FYSETC/FYSETC-AIO_II/(threads)

Thread 3 (2020-04-10):

Schemes and other bits for module 4xTMC2208 for AIO II board

sl1pkn07, 2020-04-10:
Hi

i just discover exist a module for this board with TMC2208 drivers

https://es.aliexpress.com/item/4000337065284.htm

is possible add to the repo the schemes/layout/otherbits to the repo?

greetings

Cadaxe20000, 2020-05-11:
I have ordered one with 2208 and I can't find anywhere how to resolve compailing issues for 2208 pins

sl1pkn07, 2020-06-26:
unit received today

any notice of the schemes and push the marlin configuratin for this drivers in upstream?

greetings

Cadaxe20000, 2020-06-26:
No, I did asks manufacturer few times and usually they reply everything is
included on GitHub.

On Fri, 26 Jun 2020, 14:47 Gustavo Alvarez, <notifications@github.com>
wrote:

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

sl1pkn07, 2022-02-23:
practically almost 2 years later, but now done

tnx!

Closed 2022-02-23.

Thread 5 (2020-05-17):

Use AIO II with other projects than 3dprinter (SMuFF Feder). problem with the display and u8g2 lib

sl1pkn07, 2020-05-17:
Hi. i whant add support for this board in this project

https://github.com/technik-gegg/SMuFF-1.1

the pinout is set, but the display show nothing. the library used for the display is the u8g2 https://github.com/olikraus/u8g2 and set as `U8G2_ST7567_JLX12864_1_4W_HW_SPI` and also test with `U8G2_UC1701_MINI12864_1_4W_HW_SPI`

i also test the demo posted in https://github.com/olikraus/u8g2/wiki/u8g2setupcpp#introduction, but not sucess

what display controller use the AIO II?

the display seems (the code engraved in the display flat wire is LX-12864B11-3)

greetings

sl1pkn07, 2020-06-26:
fixed. need disable the JTAG pinouts in order to use the LCD

the u8g2 constructor for the LCD is `U8G2_UC1701_MINI12864_1_4W_HW_SPI`

greetings

Closed 2020-06-26.

Thread 6 (2020-05-23):

AIO II Fan1 no output

OutcastZeroOne, 2020-05-23:
Have confirmed with 2 different AIO II. one with original factory firmware, second with custom. Neither one will power the controllable fan output. I have full voltage out, but no ground signal.

OutcastZeroOne, 2020-05-25:
So far I have tried 2 different fans. confirmed full power out on the positive side of the Fan1 plug, but no ground side signal. Since half of the MOSFET that is used for the fan1 is also used for teh Blue side of the RGB control, I know that the MOSFET is functional, at least on half of the chip.

It was mentioned that there is a known issue in Marlin about a conflict with the Buzzer and PWM control. I have dissabled the Buzzer pin in the pin config and still no change.

OutcastZeroOne, 2020-06-01:
After 2 weeks of trying to get this AIO II fan1 to work, I have come to the conclusion that the board is defective. I have confirmed full power at the plug, but I have never been able to get a ground signal. I have been working directly with the Marlin developers, several of whom have AIO II boards and have tried my configuration of firmware on their boards and are able to have the fan1 fully operational.

Thread 7 (2020-11-29):

Unable to use P4 serial port pinheader

sl1pkn07, 2020-11-29:
related

https://github.com/FYSETC/Marlin-2.0.x-FYSETC/issues/21

greetings

TuguanLing, 2020-11-30:
Hello, I tested according to your configuration, it can be received and sent normally, you should be connected to the wrong line, USART2_TX and USART2_RX are PA2 and PA3 respectively. In addition, USART2 has been used in TMC2208's uart mode. Although it can receive and send instructions, it also receives instructions from TMC2208's uart mode. It is recommended not to use USART2.

sl1pkn07, 2020-11-30:
Hi

then, i can't use P4 port if use the 4xTMC2208 module? then what happen if use the the P6 header (pin header near the USB port)? is usart1 (througth CH340 bridge). the usb is irrelevant for me (only when i need flash the formware)

greetings

TuguanLing, 2020-12-01:
If you use USART1, you do not need to turn on SERIAL_PORT_2,USB to send instructions and burn firmware, but the P6 interface cannot be directly used for WiFi modules to send instructions. USART1_TX and USART1_RX need to be extracted from MCU. Check the schematic diagram in detail

sl1pkn07, 2020-12-01:
according to STM32f103RCT6 datasheet (https://www.st.com/resource/en/datasheet/stm32f103rc.pdf) this Mcu, also have USART3, wich in AIOII schemes, is also the P4 header, the low row (PB10 (SCL) and PB11 (SCA))

but this connection, have 2 resistors (4,7K). exist any problem if i use as serial port as-sis? or i need retire the resistors?

greetings

TuguanLing, 2020-12-02:
USART3 can be used normally, no need to retire the resistors, does not affect the normal use.

sl1pkn07, 2020-12-02:
thanks for confirm . i have tested in my 2 units units and works ok in USART3 (`SERIAL_PORT_2 3`) (when use 4xTMC2208 module) and  USART2 (`SERIAL_PORT_2 2`) and USART3 (`SERIAL_PORT_2 3`) when use 4xST820 module

greetings

PD: is cross-related with https://github.com/FYSETC/FYSETC-AIO_II/issues/3. 4xTMC2208 module schemes and other bits is missing in the repository

Closed 2020-12-02.

Thread 8 (2021-08-21):

How to connect 3D Touch/ BL Touch to AIO II

yeohandy, 2021-08-21:
I've just recently acquired the AIO II and would like to use it with 3D Touch/ BL Touch. Do you have instructions for it?

yzheka, 2023-03-22:
If you don't use rgb led, you can use one of R, G or B pins as a control pin for bltouch

Thread 9 (2021-09-10):

please clarify the non documented motor wiring

PGTBoos, 2021-09-10:
PLease can you clarify how to motors are wired ?.
There is a PDF schematics here, but looking from the top of it, I cannot tell how it is wired.
It seems connecters X Y are 180 degree turned, as compared to up and down

As for up and down is their wiring   Red Bleu Green Black   ?
I'm replacing a Sanguinololu microcontroller, they have it pretty clear : https://reprap.org/wiki/File:Sanguinololu12.svg

Thread 10 (2024-02-15):

Add AIO II Klipper config

Xerusen, 2024-02-15:
I adapted and tested cheetah v1.2 config to work with AIO II
```
# This file contains common pin mappings for the FYSETC AIO II board.
# To use this config, the firmware should be compiled for the
# STM32F103 with "No bootloader" and serial (on USART1 PA10/PA9)
# communication.

# The "make flash" command does not work on the  AIO II. Instead,
# after running "make", run the following command to flash the board:
#  stm32flash -w out/klipper.bin -v -i rts,-dtr,dtr /dev/ttyUSB0

# See docs/Config_Reference.md for a description of parameters.\

[mcu]
serial:/dev/serial/by-id/usb-1a86_USB_Serial-if00-port0
restart_method: cheetah

[printer]
kinematics: cartesian
max_velocity: 300
max_accel: 3000
max_z_velocity: 5
max_z_accel: 100

[stepper_x]
step_pin:PB8
dir_pin: !PB9
enable_pin: !PA8
microsteps: 16
rotation_distance: 40
endstop_pin: ^PA1
position_endstop: 0
position_max: 200
homing_speed: 50

[tmc2208 stepper_x]
uart_pin:PA3
uart_address:0
run_current: 0.8
stealthchop_threshold: 999999

[stepper_y]
step_pin: PB2
dir_pin: !PB3
enable_pin: !PB1
microsteps: 16
rotation_distance: 40
endstop_pin:PA0
position_endstop: 0
position_max: 200
homing_speed: 50

[tmc2209 stepper_y]
uart_pin:PA3
uart_address:1
run_current: 0.800
stealthchop_threshold: 999999

[stepper_z]
step_pin: PC0
dir_pin: PC1
enable_pin: !PC2
microsteps: 16
rotation_distance: 8
endstop_pin: ^PB14
position_endstop: 0
position_max: 200

[tmc2209 stepper_z]
uart_pin:PA3
uart_address:2
run_current: 0.800
stealthchop_threshold: 999999

[extruder]
step_pin: PC15
dir_pin: !PC14
enable_pin: !PC13
microsteps: 16
rotation_distance: 33.500
nozzle_diameter: 0.400
filament_diameter: 1.750
heater_pin: PC6
sensor_type: EPCOS 100K B57560G104F
sensor_pin: PC4
control: pid
pid_kp: 21.527
pid_ki: 1.063
pid_kd: 108.982
min_temp: 0
max_temp: 250

[tmc2209 extruder]
uart_pin:PA3
uart_address:3
run_current: 1.0
stealthchop_threshold: 999999

[heater_bed]
heater_pin: PC7
sensor_type: EPCOS 100K B57560G104F
sensor_pin: PC5
control: pid
pid_kp: 54.027
pid_ki: 0.770
pid_kd: 948.182
min_temp: 0
max_temp: 120

[fan]
pin: PC8

[display]
#	mini12864 LCD Display
lcd_type: uc1701
cs_pin: PB5
a0_pin: PA15
rst_pin: PB4
#   The pins connected to a uc1701 type lcd.
encoder_pins: ^PC10,^PC11
#   The pins connected to encoder. 2 pins must be provided.
click_pin: ^!PC12
#   The pin connected to 'enter' button or encoder 'click'.
contrast: 63
spi_software_miso_pin: PA6
spi_software_mosi_pin: PA7
spi_software_sclk_pin: PA5

[led fysetc_mini12864]
red_pin:PB0
green_pin:PB6
blue_pin:PB7
#   The pin controlling the given LED color.
cycle_time: 0.010
#   The amount of time (in seconds) per PWM cycle.
#hardware_pwm: False
#   Enable this to use hardware PWM instead of software PWM.
initial_RED: 0.0
initial_GREEN: 1.0
initial_BLUE: 0.0
#   Sets the initial LED color. Each value should be between 0.0 and
#   1.0. The default for each color is 0.

[output_pin BEEPER_Pin]
pin: PC9
pwm: true
value: 0
shutdown_value: 0
cycle_time: 0.001
scale: 1000
```

mrmohaa, 2025-03-18:
A heads up, it looks like the UART addresses for Y and Z are swapped.
Y should be address 2 and Z should be address 1.

Getting my printer running with this board and trying to use sensorless homing and could not get the Y axis to trigger stall guard, X was working fine. Tried swapping UART addresses around and then Y homed fine.
Looked at the 2209 module schematic and the MS1 and MS2 lines set the address, and looking at the 2209 data sheet it confirmed it.
