FYSETC/FYSETC-AIO_II/hardware/4X ST820 V1.2 SCH.pdf

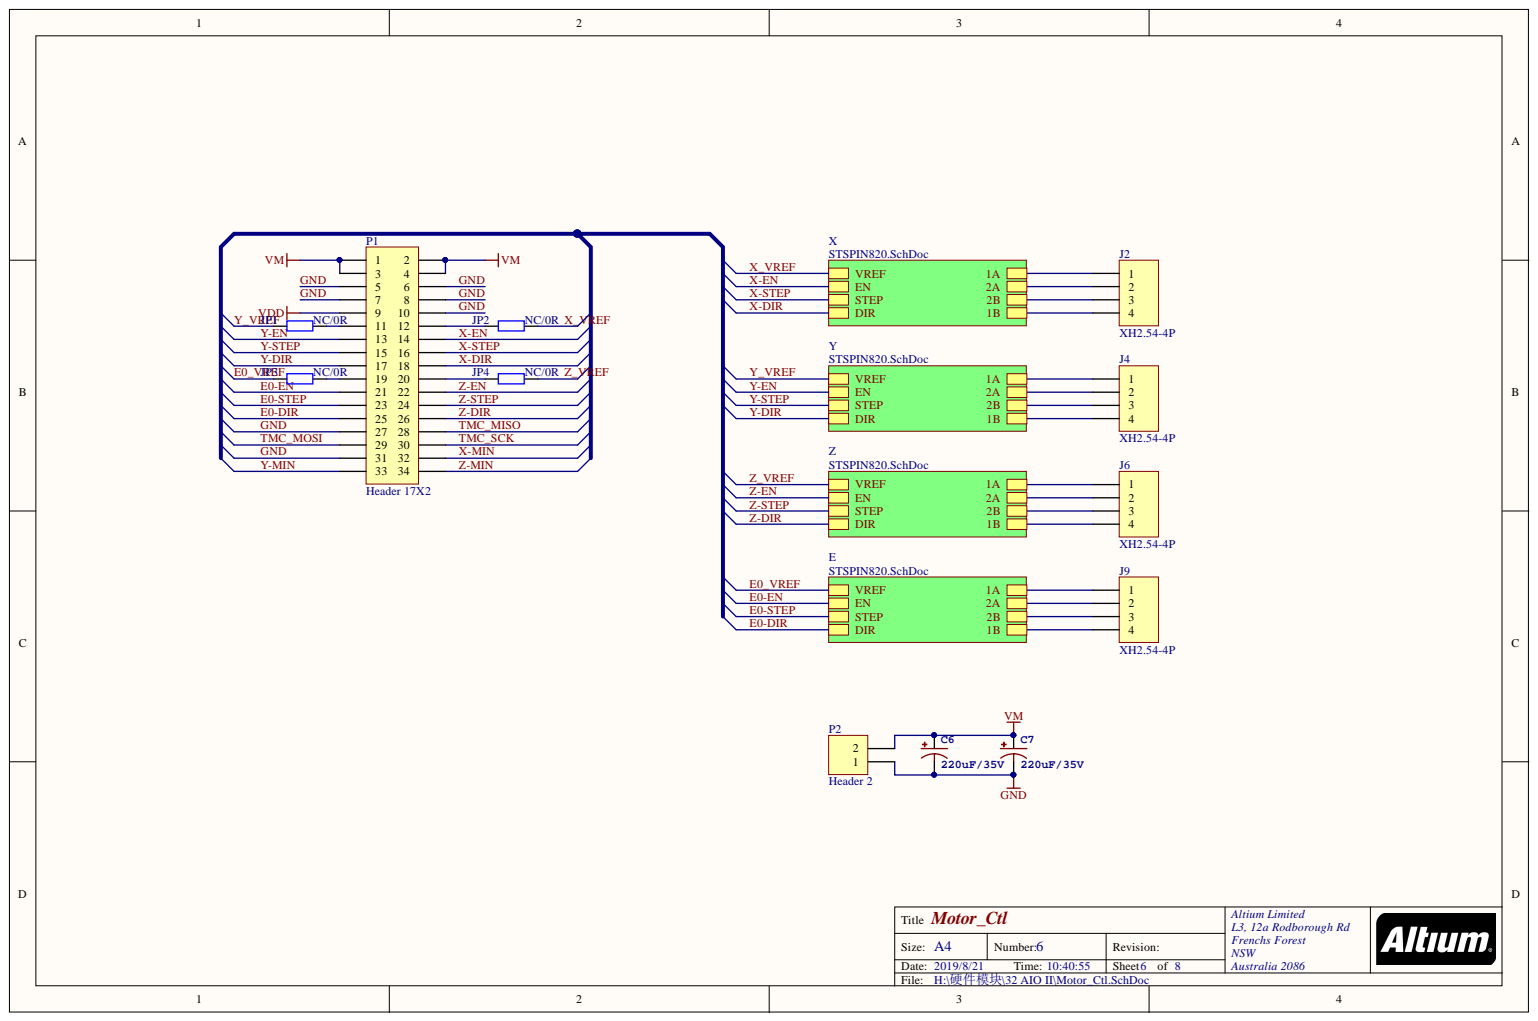
[picture p8: page 1]
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

Size: A4 | N umber: 6 | Rev i s i o n :
Date: 2 0 1 9 / 8 / 2 1 T ime: 1 0 : 4 0 : 5 5 | | Sheet 6 o f 8

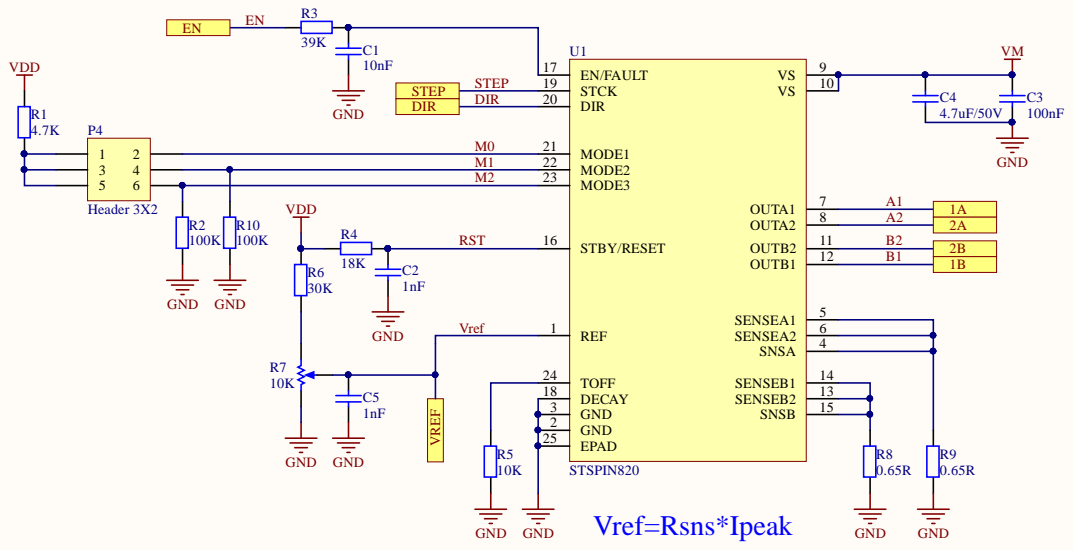
[picture p9: page 2]

1 8 | 1
3 | 1 5
