FYSETC/FYSETC-AIO_II/hardware/4X 2208 SCH.pdf

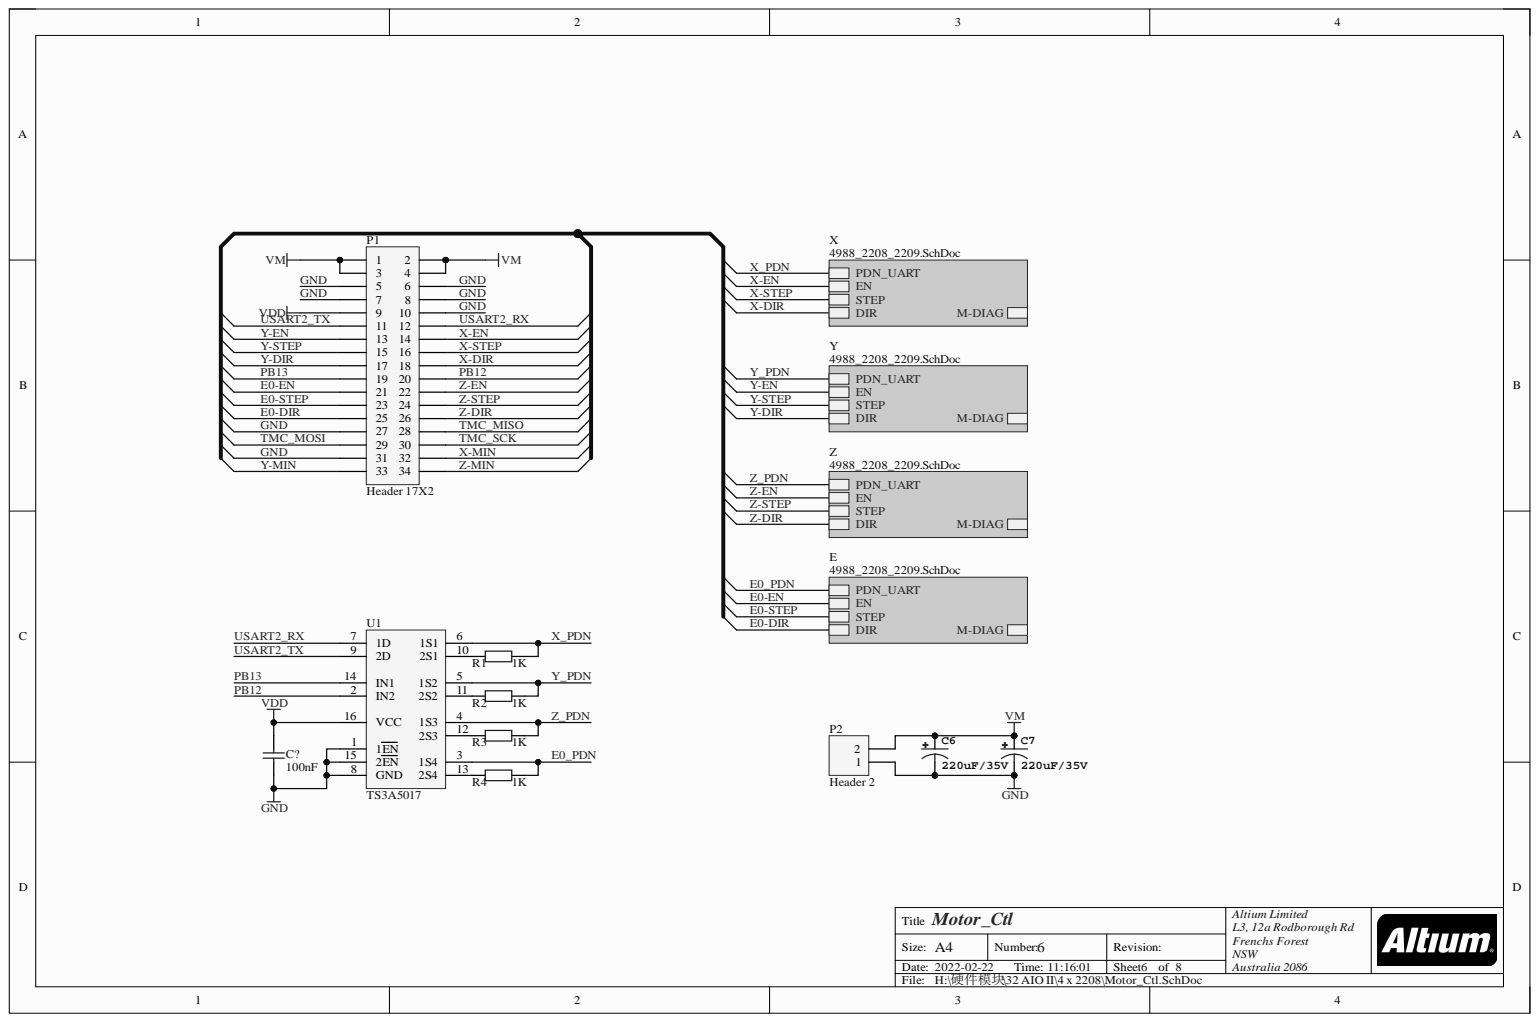
[picture p10: page 1]

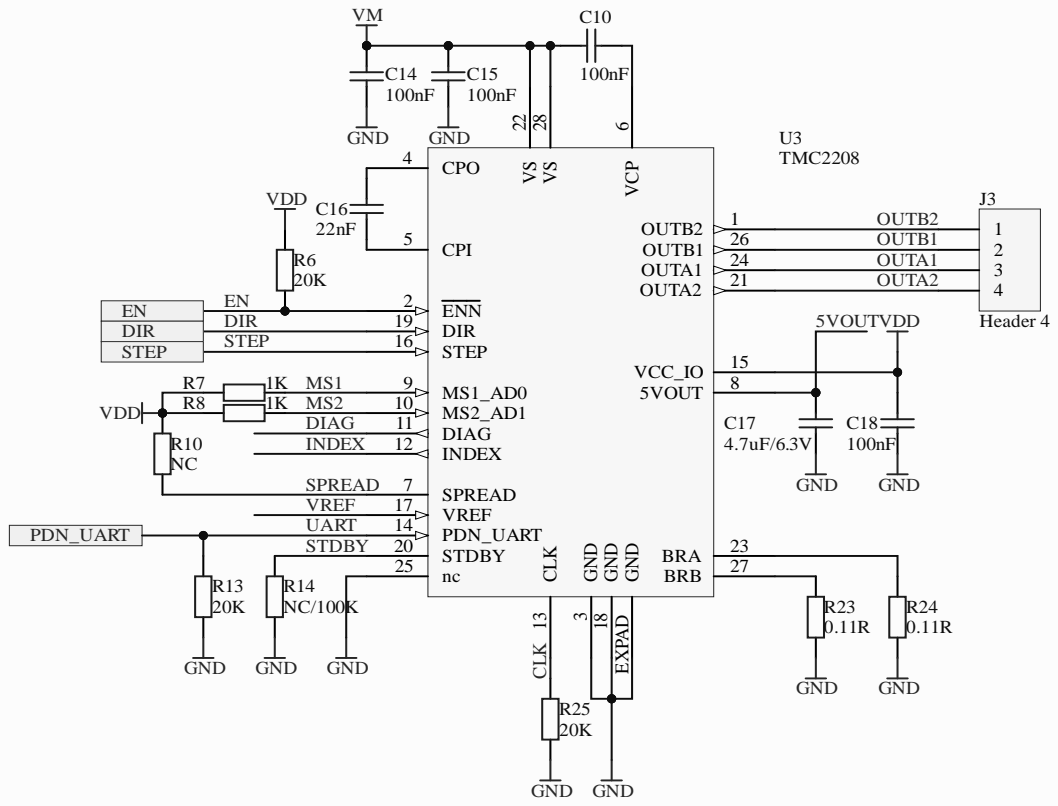
[picture p11: page 2]
