FYSETC/FYSETC-AIO_II/hardware/4X 2208 V1.0 位号图.pdf

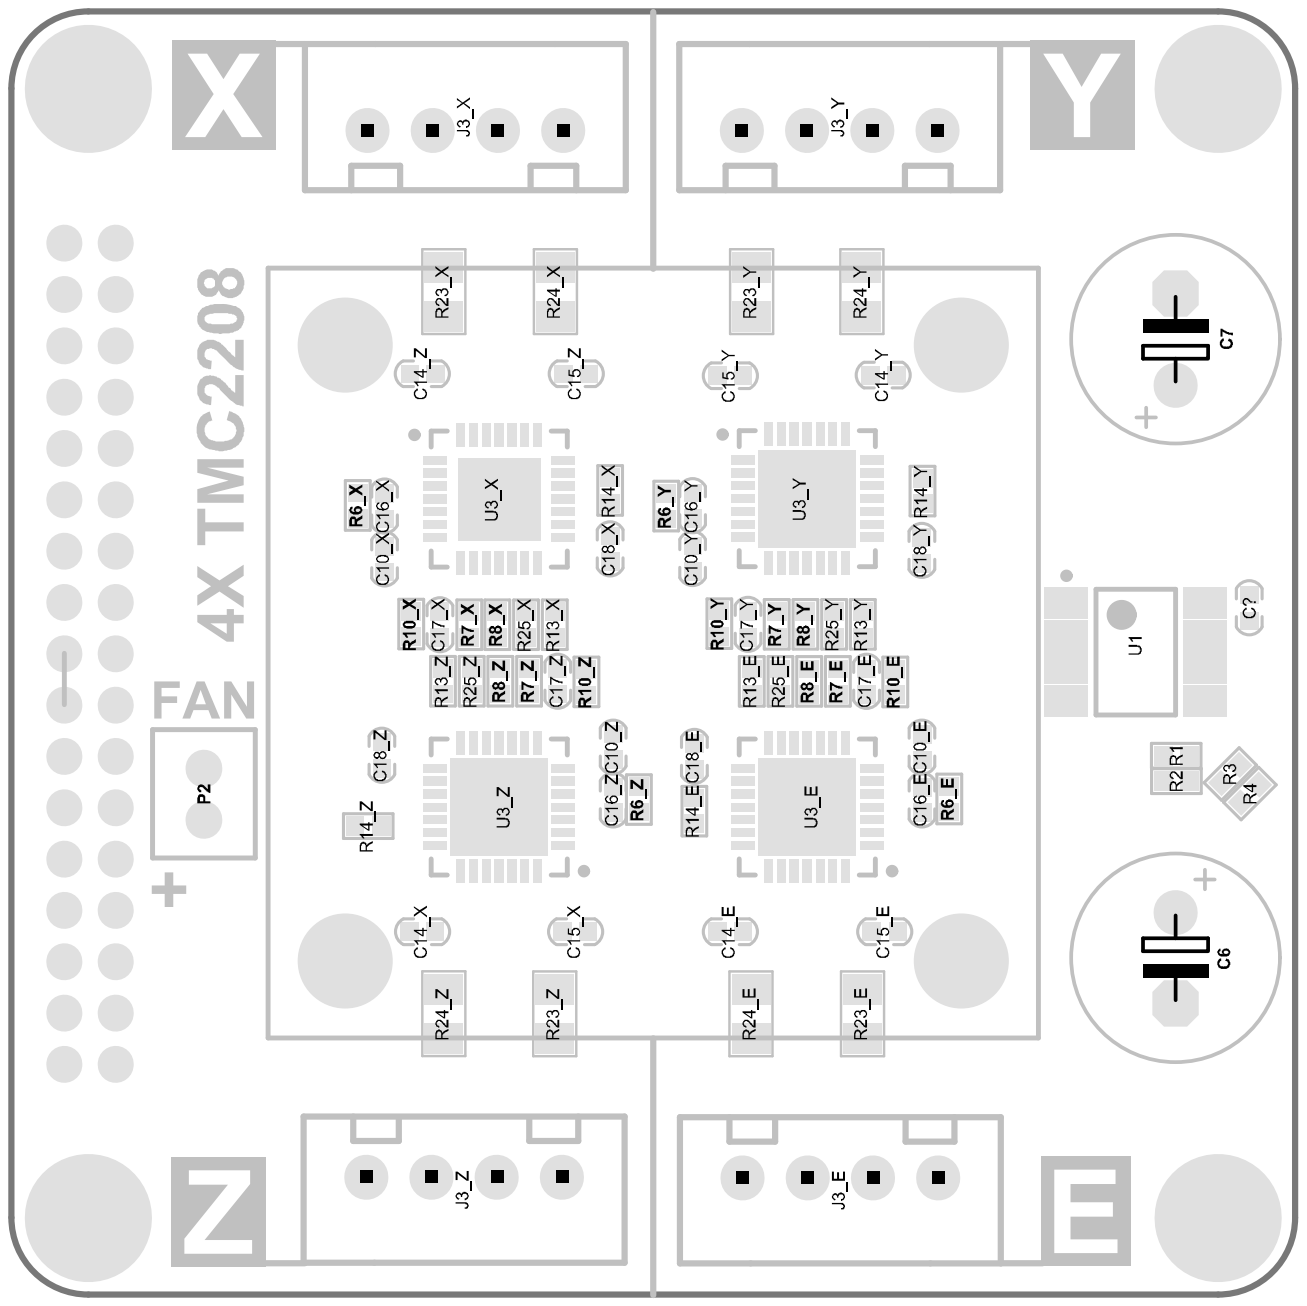
[picture p12: page 1]
