FYSETC/FYSETC-AIO_II/hardware/4X 2209 SCH.pdf

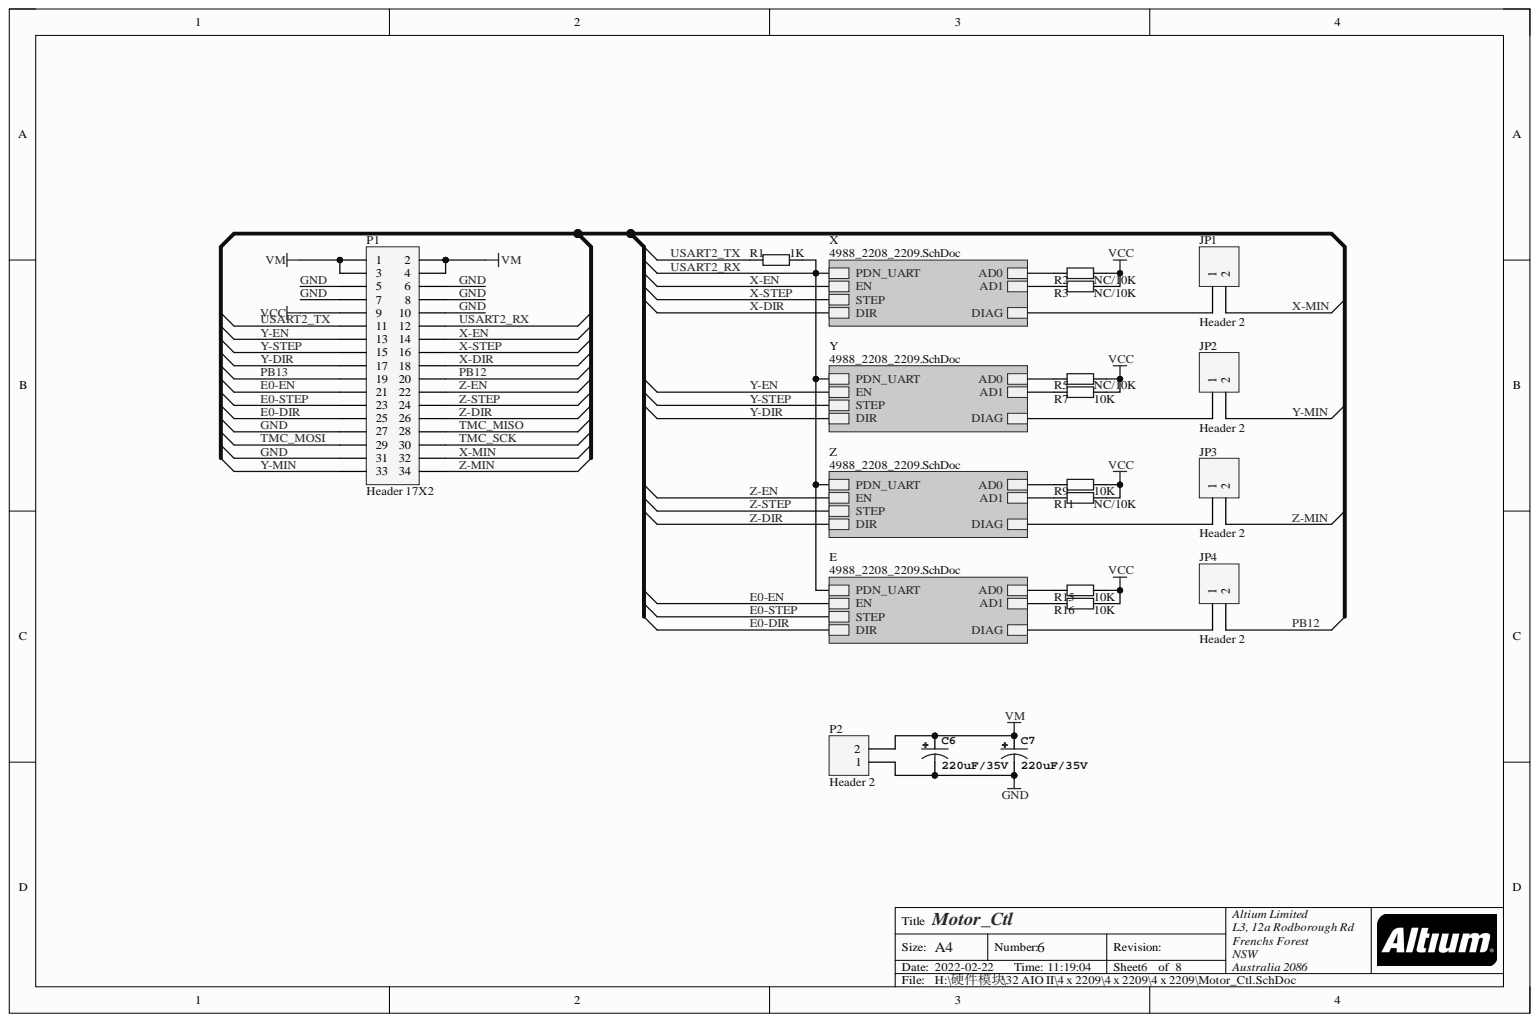
[picture p13: page 1]

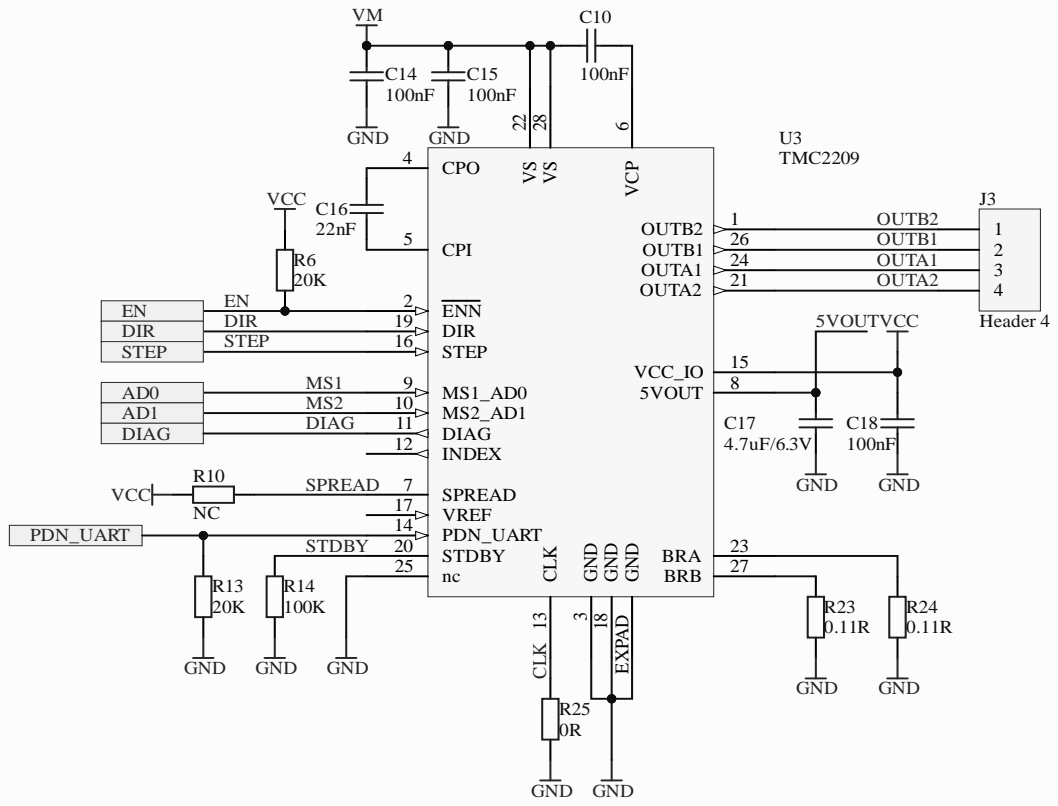
[picture p14: page 2]
