FYSETC/FYSETC-AIO_II/hardware/4X 2209 V1.1 位号图.pdf

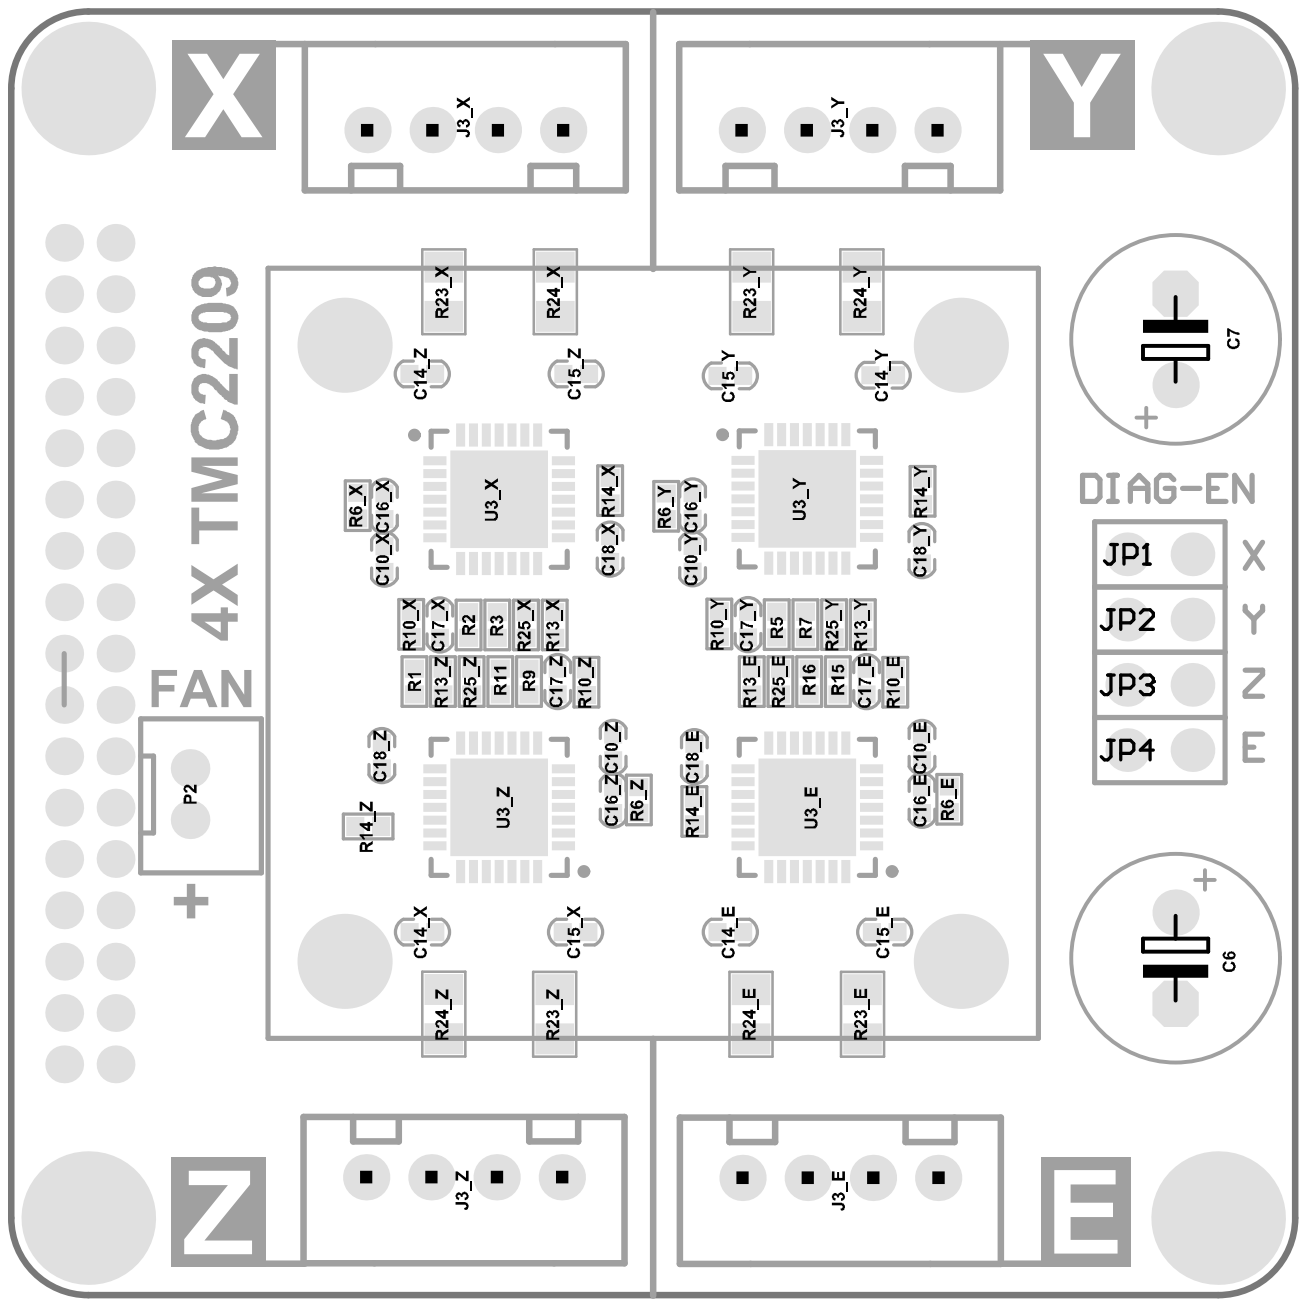
[picture p15: page 1]
