FYSETC/FYSETC-AIO_II/hardware/4X ST820 V1.2位号图.pdf

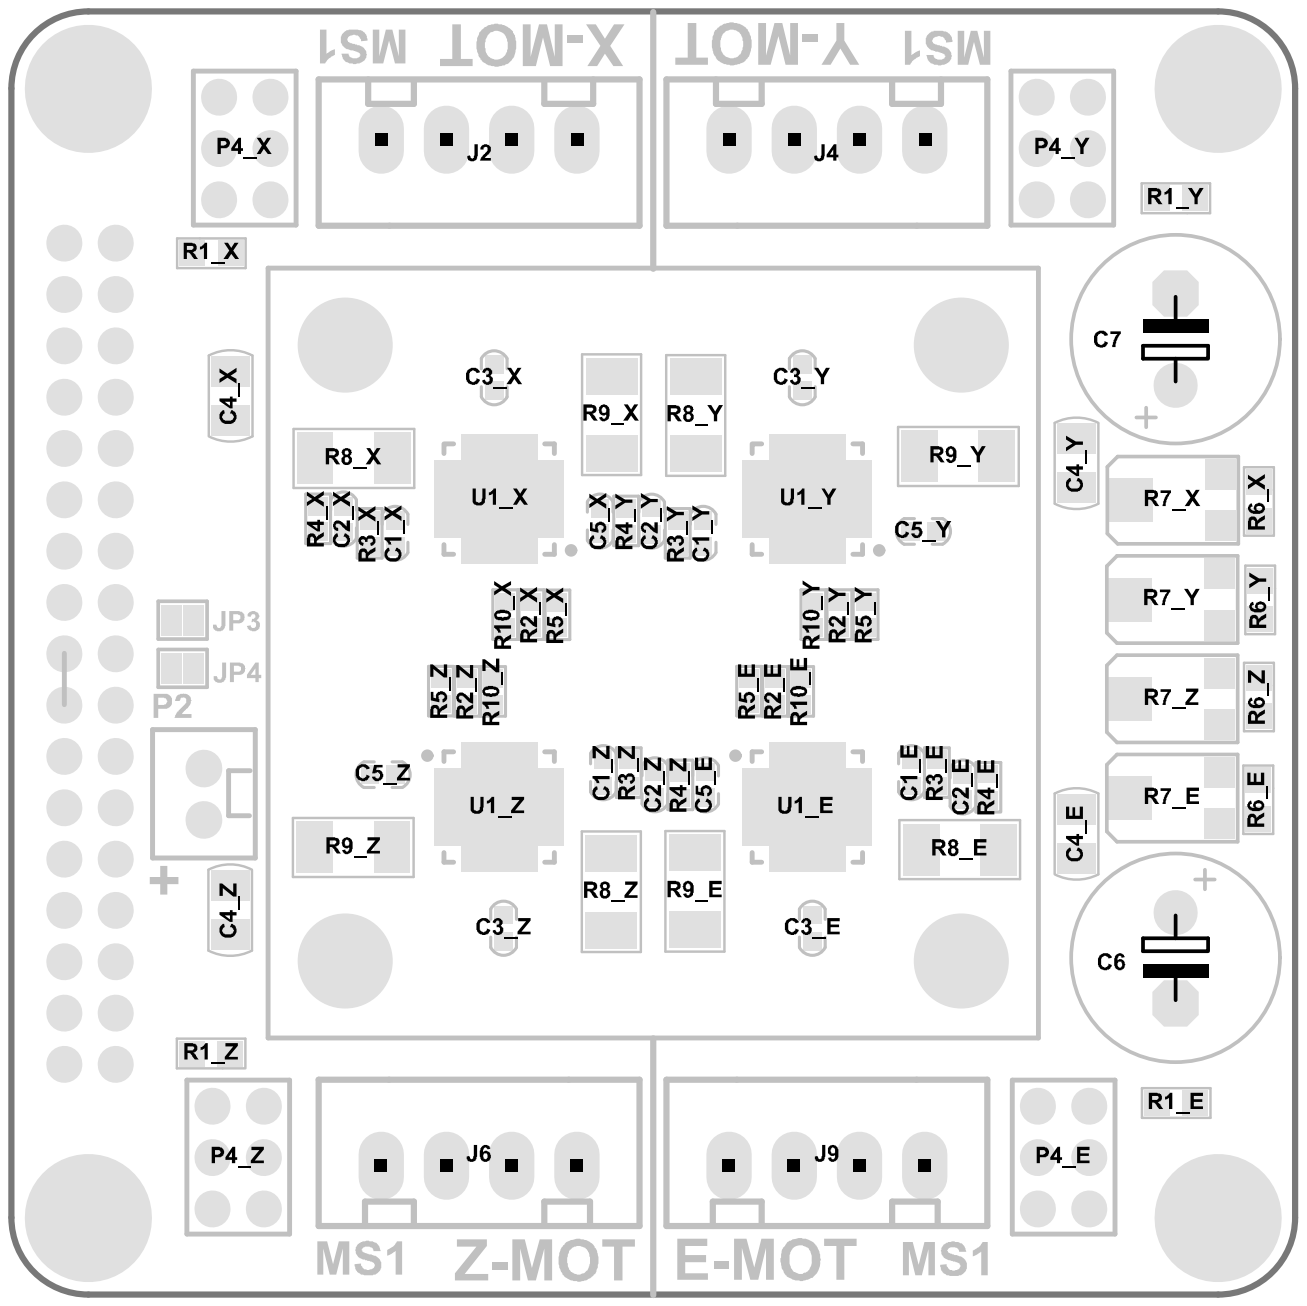
[picture p16: page 1]
