FYSETC/FYSETC-AIO_II/hardware/AIO II V3.2 SCH.pdf

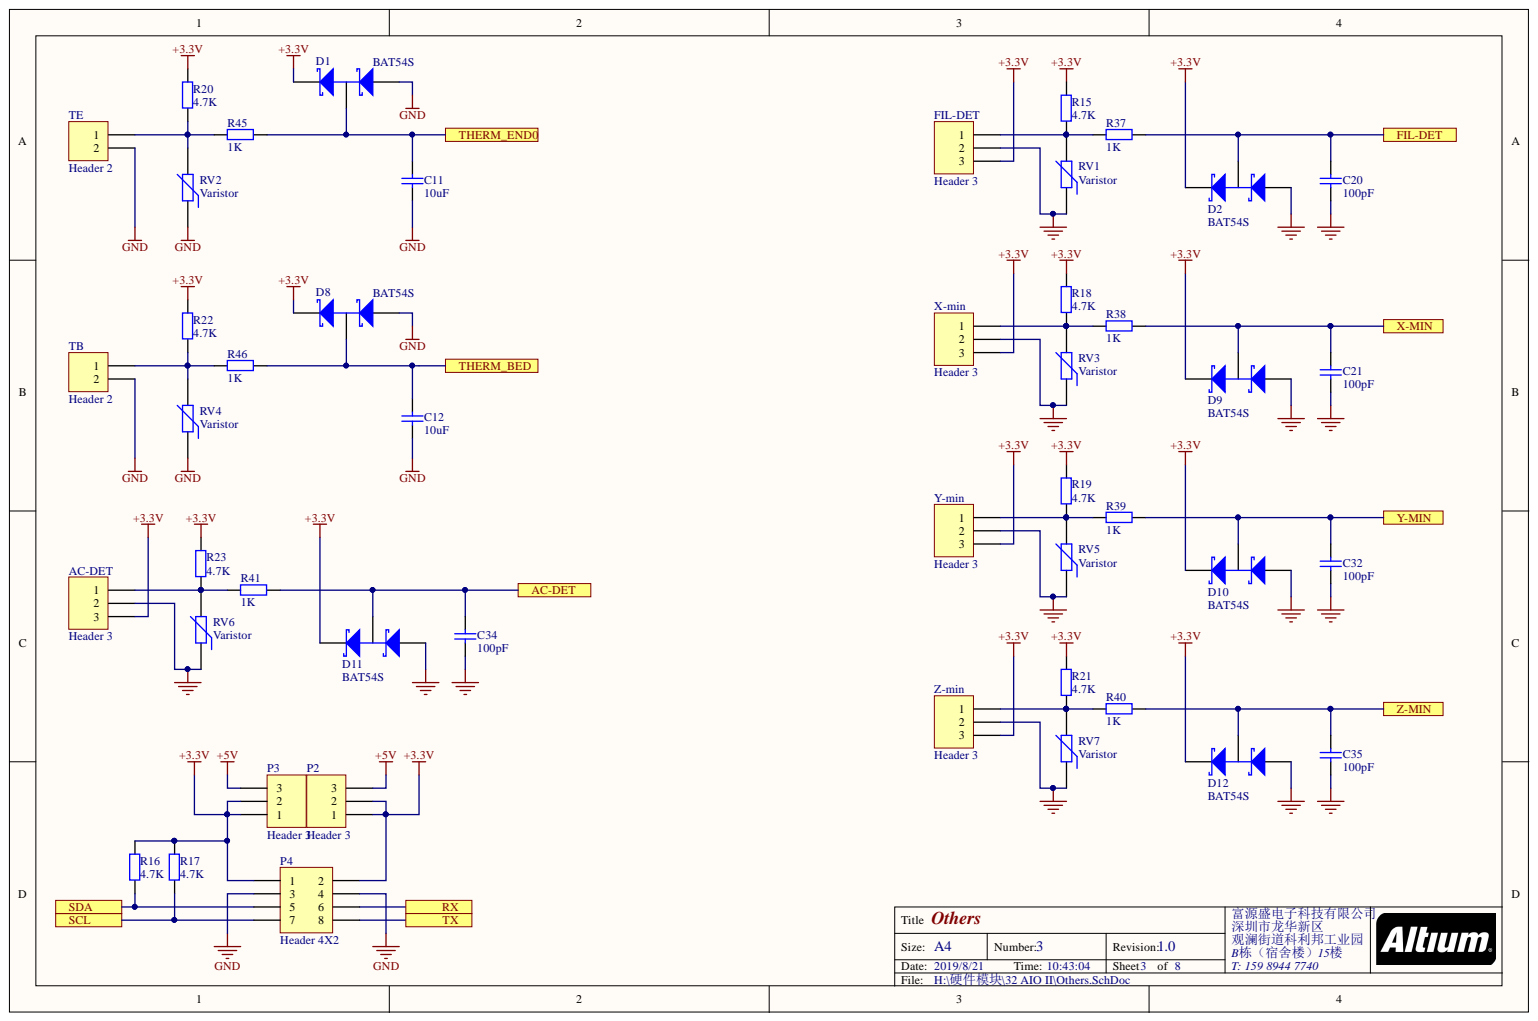
[picture p17: page 1]

Header 3 123 Y-min Header 3 123 Z-min Header 3

Others T i t l e | 富源盛电子科技有限公司 深圳市龙华新区 观澜街道科利邦工业园 B栋（宿舍楼）15楼 T: 1 9 8 4 7

Size: A4 | N umber: 3 | Rev i s i o n : 1.0
Date: / T ime: : | | Sheet f

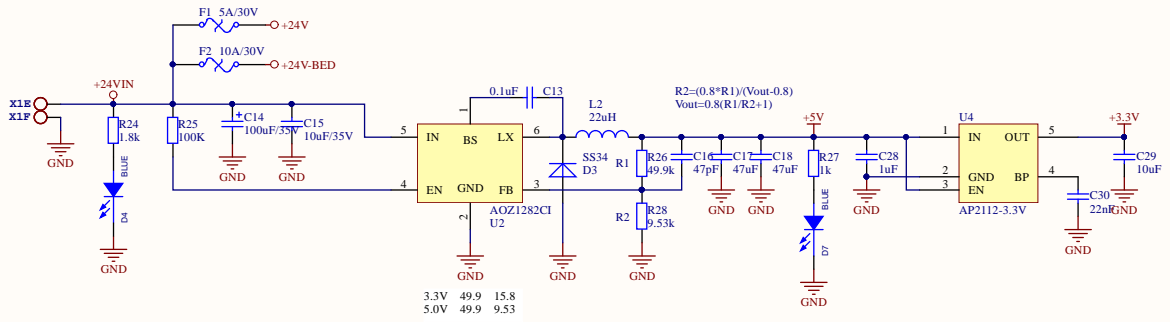
[picture p18: page 2]

Power T i t l e | 富源盛电子科技有限公司 深圳市龙华新区 观澜街道科利邦工业园 B栋（宿舍楼）15楼 T: 1 9 8 4 7

Size: A4 | N umber: 4 | Rev i s i o n : 1.0

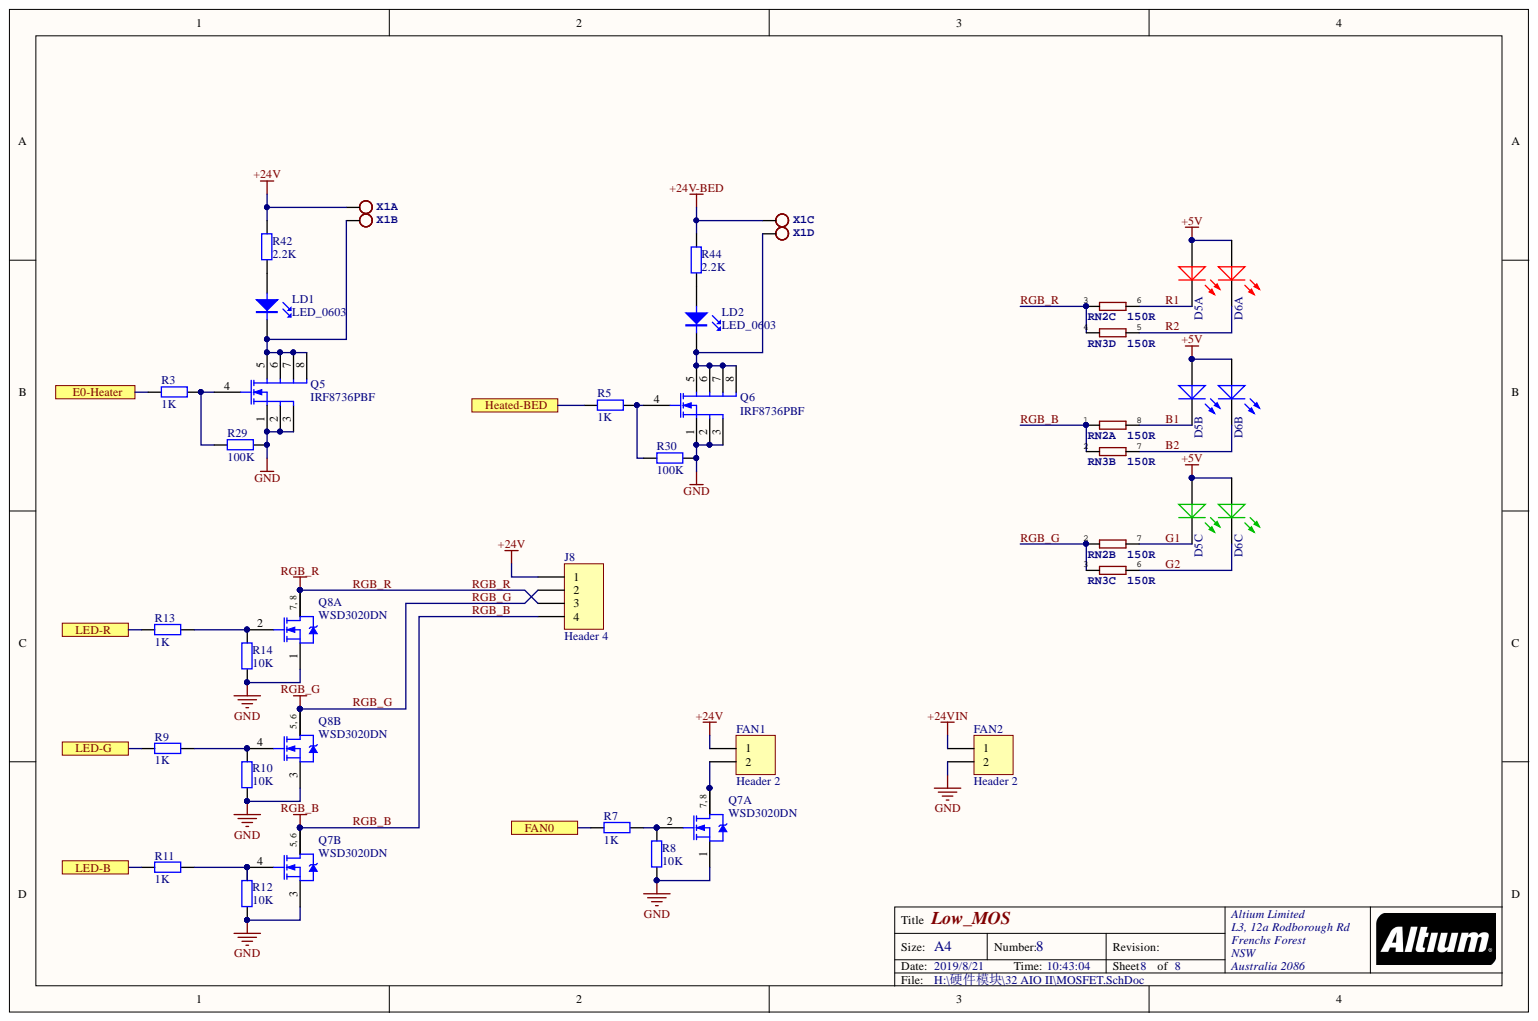
[picture p19: page 3]
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

Size: A4 | N umber: 8 | Rev i s i o n :

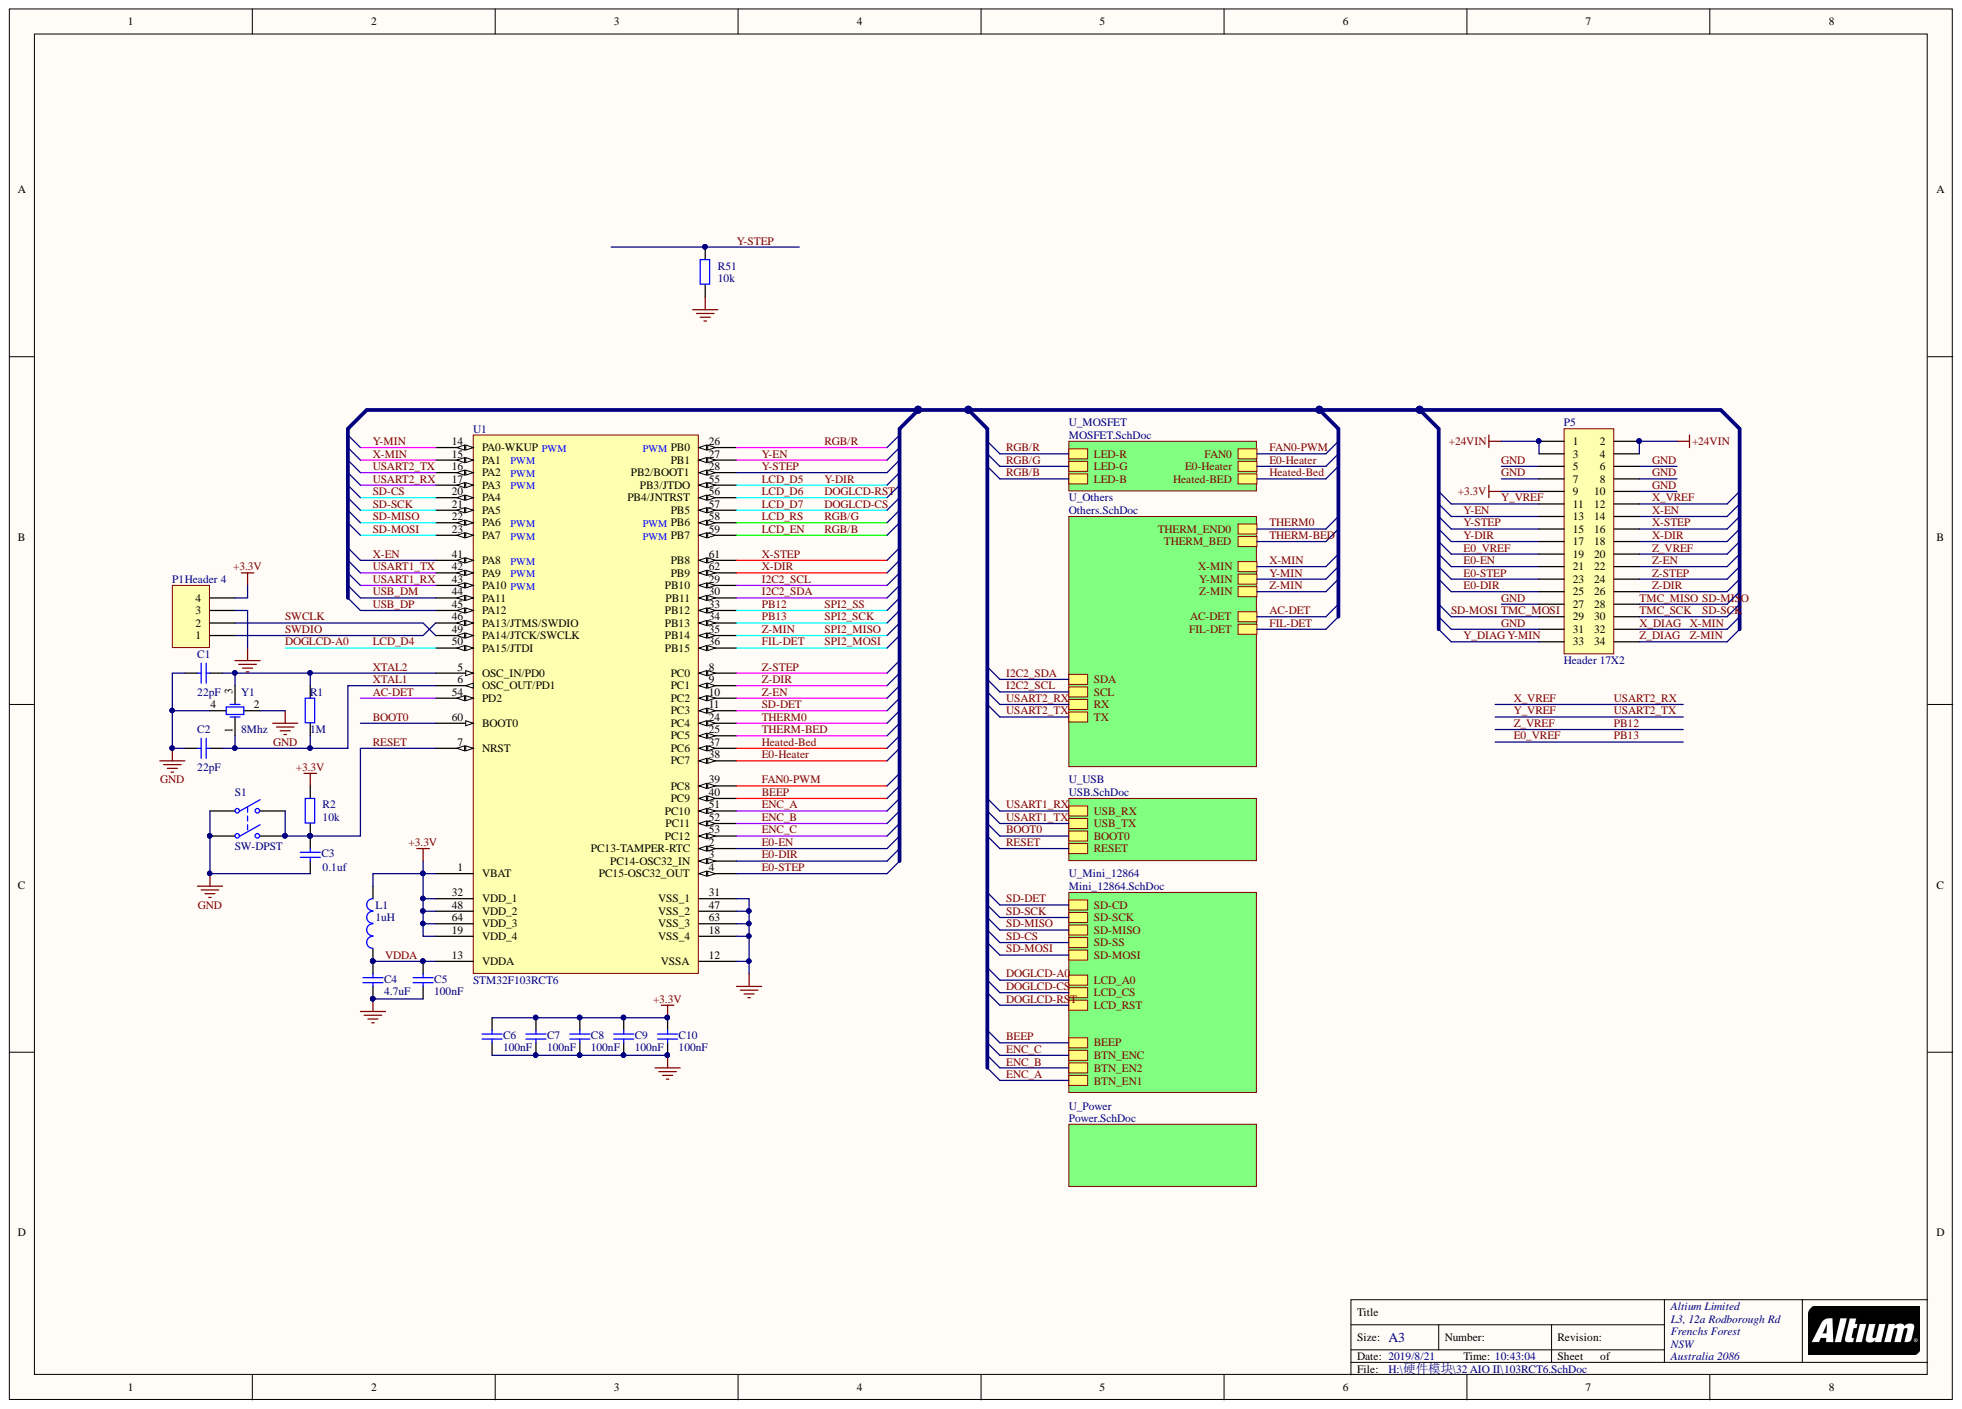
[picture p20: page 4]

Ti l e | A l ium Li m i ted L3, 12a Rodborough R d F renchs Fores NSW Aus ral ia 2086

Size: A | Number | Revi s ion:
2019/8/21 Ti me: 10:43:04 | | Sheet of

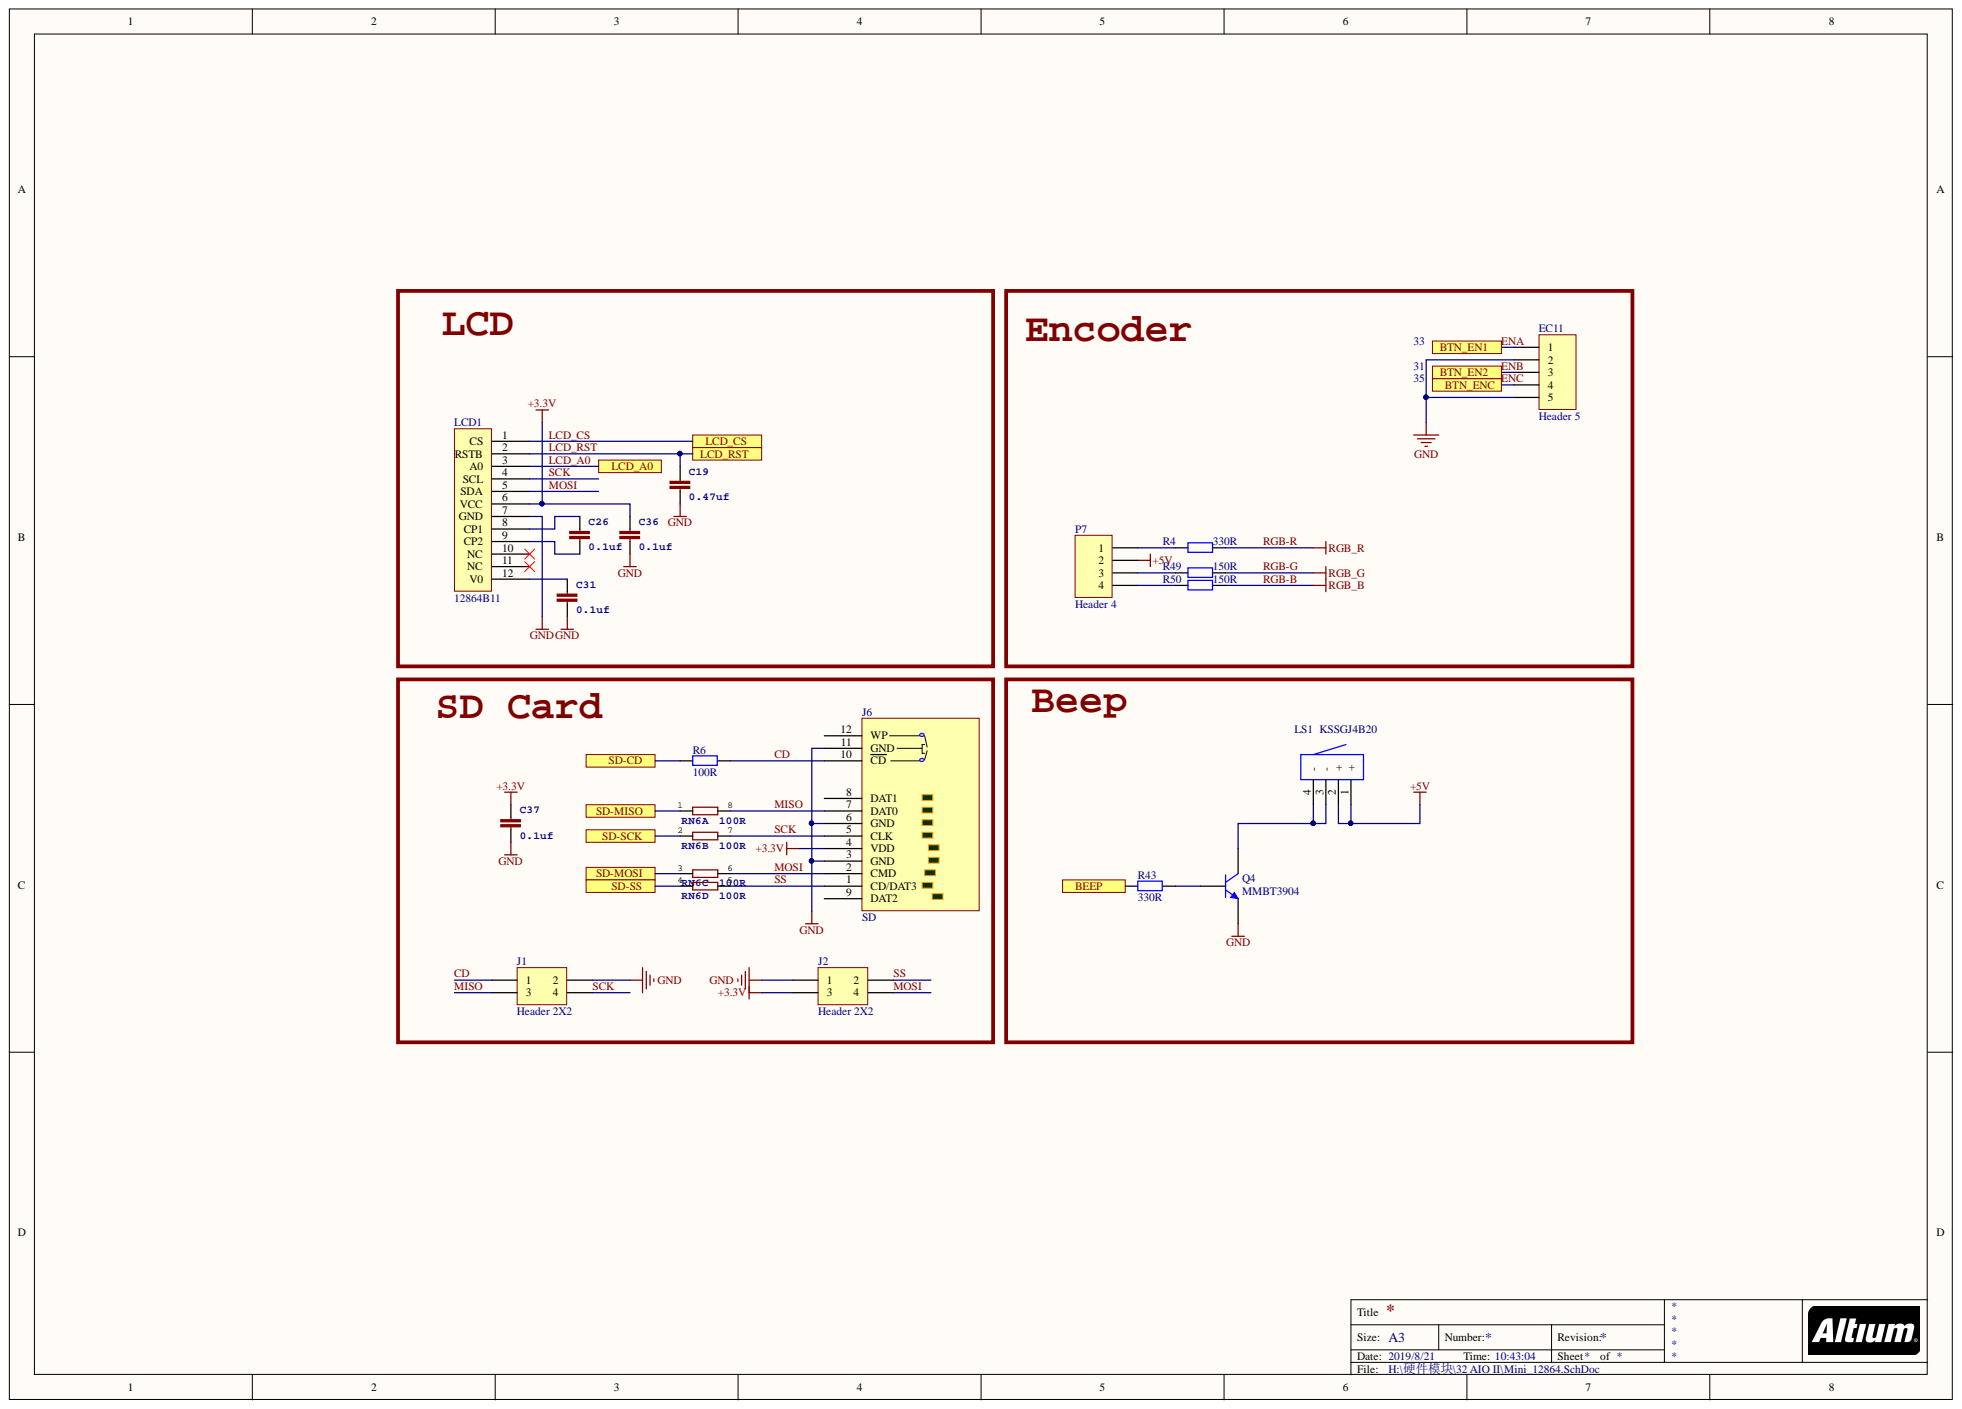
[picture p21: page 5]

* Title | * * * * *

Size: A3 | Number: * | Revision: *
2019/8/21 Time: 10:43:04 | | Sheet * of *

H:\硬件模块\32 AIO II\Mini_12864.SchDoc
File:

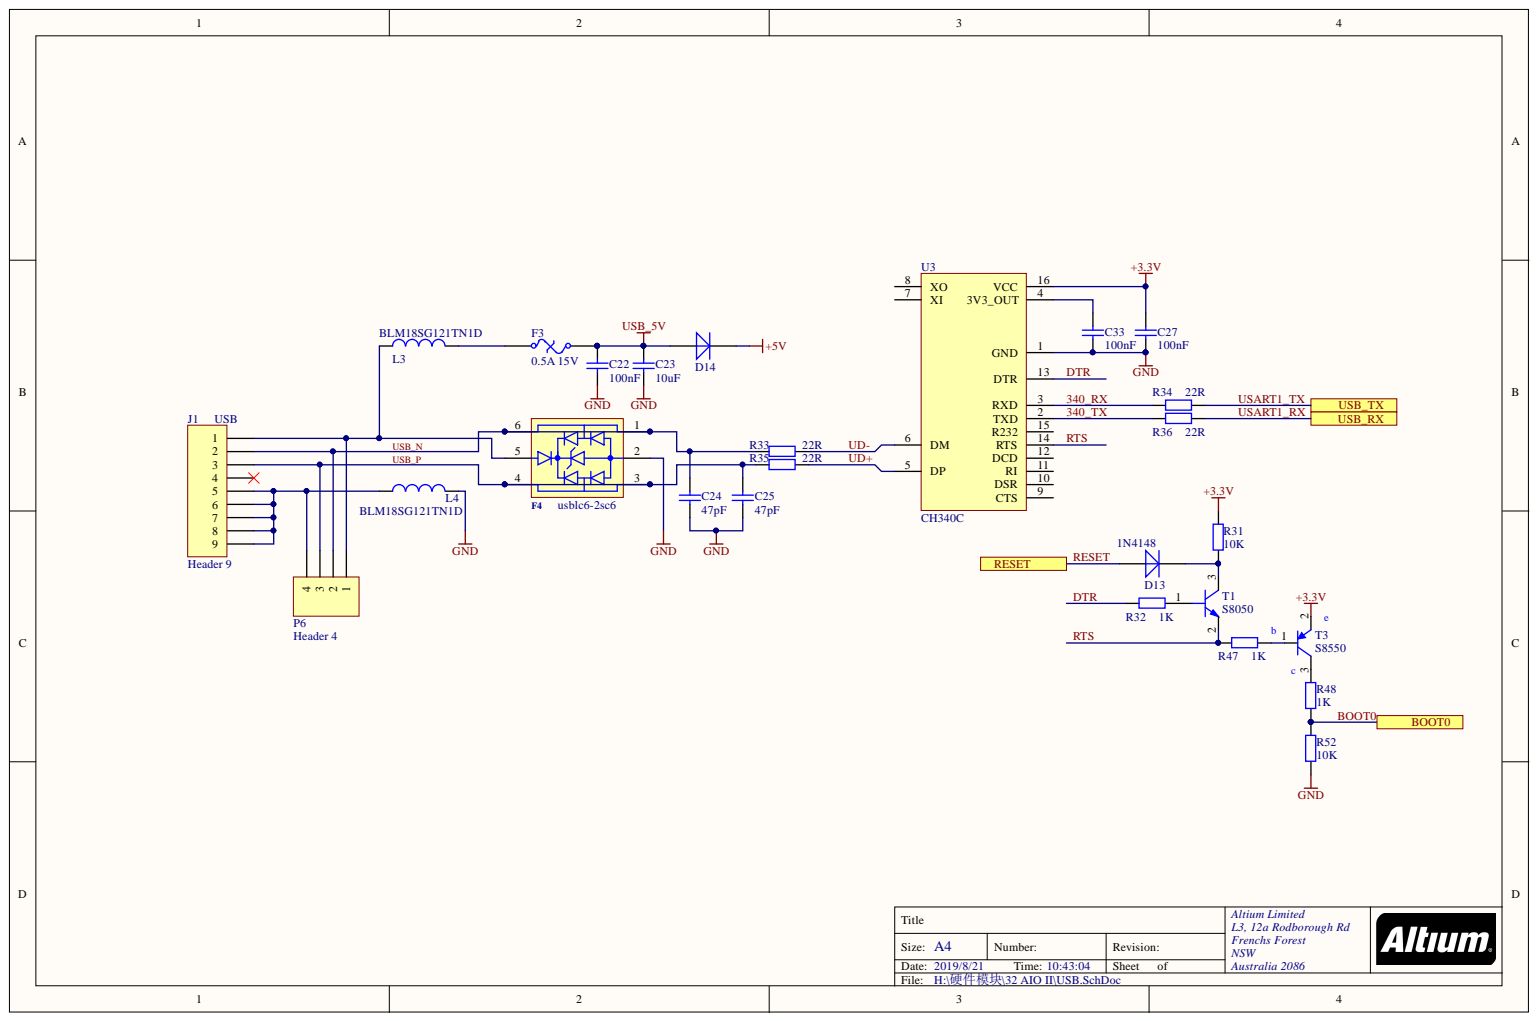
[picture p22: page 6]

Title | Altium Limited L3, 12a Rodborough Rd Frenchs Forest NSW Australia 2086

Size: A4 | Number: | Revision:
2019/8/21 Time: 10:43:04 | | Sheet of

H:\硬件模块\32 AIO II\USB.SchDoc
File:
