FYSETC/FYSETC-AIO_II/hardware/AIO II V3.2 位号图.pdf

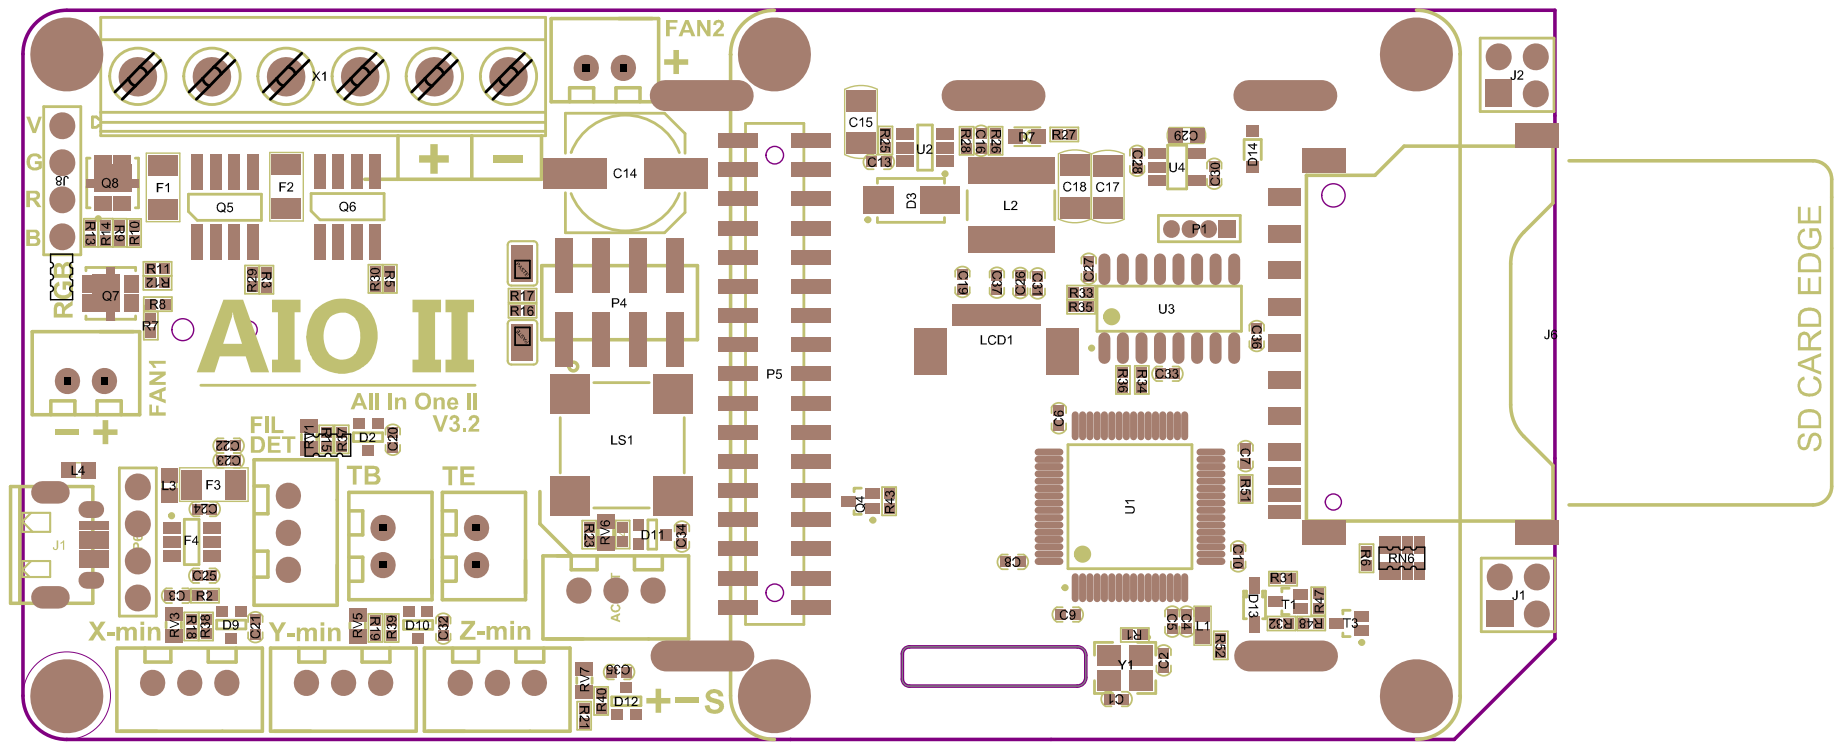
[picture p23: page 1]

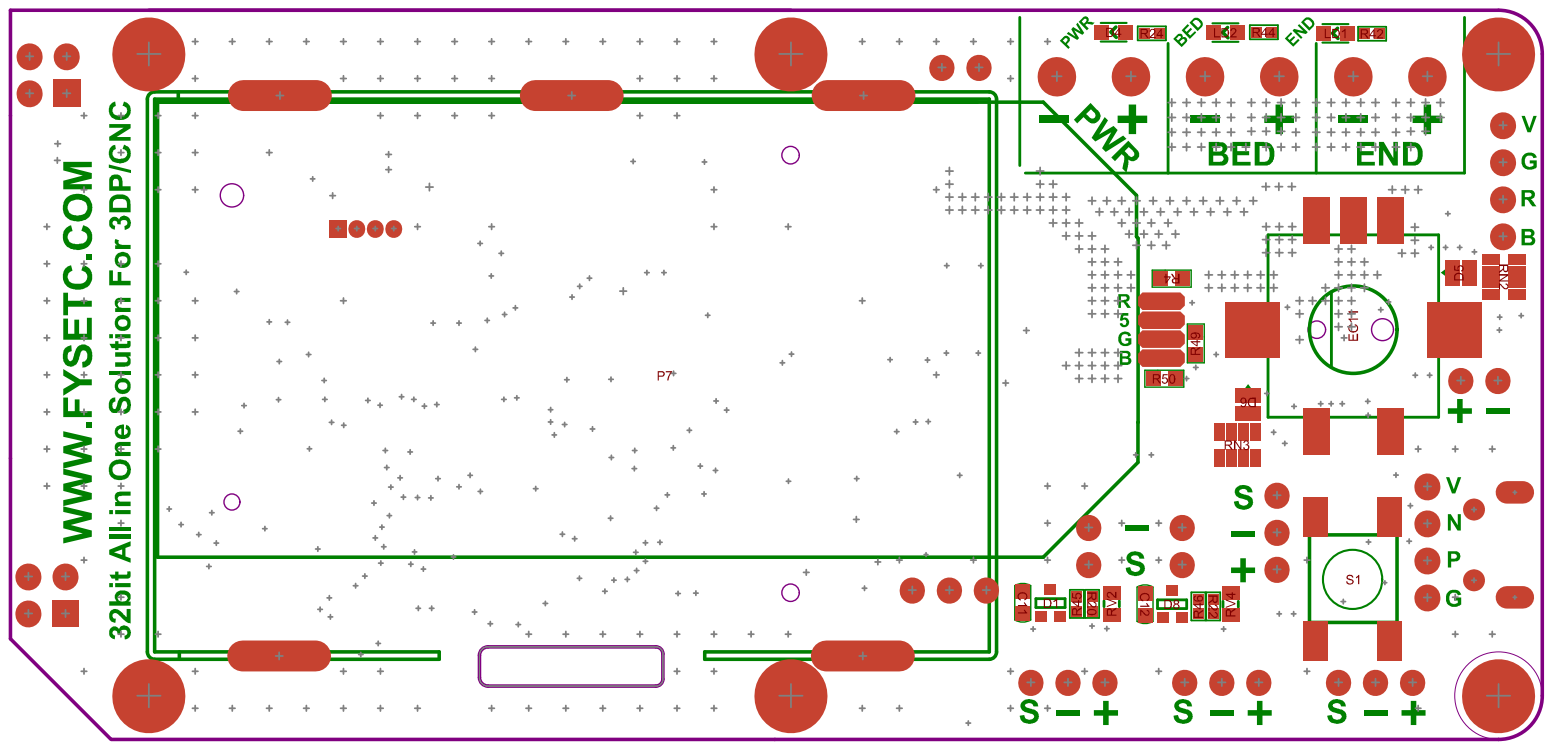
[picture p24: page 2]
