FYSETC/FYSETC-AIO_II/(commit log)

2020-12-01 Upload Marlin
    [Configuration.h, Configuration_adv.h]
2021-06-03 Update Marlin
    [Configuration.h, Configuration_adv.h]
